ozerik/EasyEi8ht/EasyEi8ht schematic.jpeg

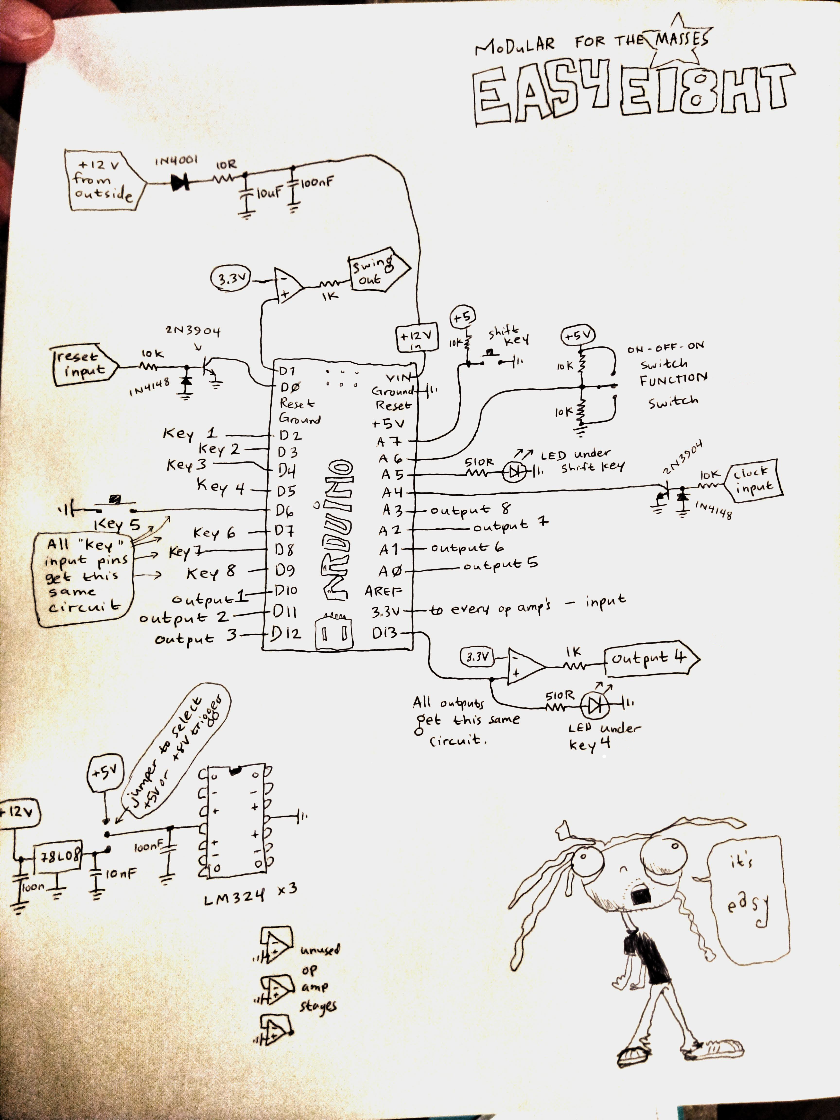
EasyEi8ht schematic.jpeg
