ozerik/EasyEi8ht/EasyEi8ht BOM.xlsx

Easy Ei8ht BOM
part | quantity
Arduino Nano 3 with the ATMega328
LM324 quad op amp | 3
2N3904 NPN transistor | 2
1N4148 signal diode | 2
1N4001 rectifying diode | 1
78L08 8V voltage regulator | 1
3mm high brightness LED whatever color | 8 | These sit under the keyswitches
3mm high brightness LED a different color if you like | 1 | this one sits under the shift key
 | 9
ON-OFF-ON three position SPST toggle switch | 1
10R resistor | 1
510R resistor | 9
1K resistor | 9
10K resistor | 5
10nF ceramic disc capacitor | 1
100nF ceramic disc capacitor | 5
10uF electrolytic capacitor (16V or higher) | 1
